FuNK3Y/picoKVM/hardware/revA/img/bottom.png

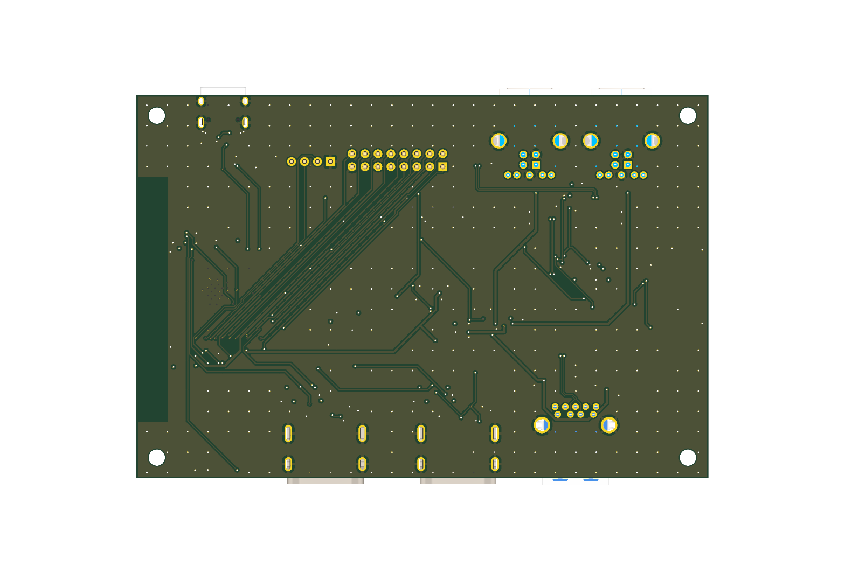
hardware/revA/img/bottom.png
