FuNK3Y/picoKVM/hardware/revA/img/top.png

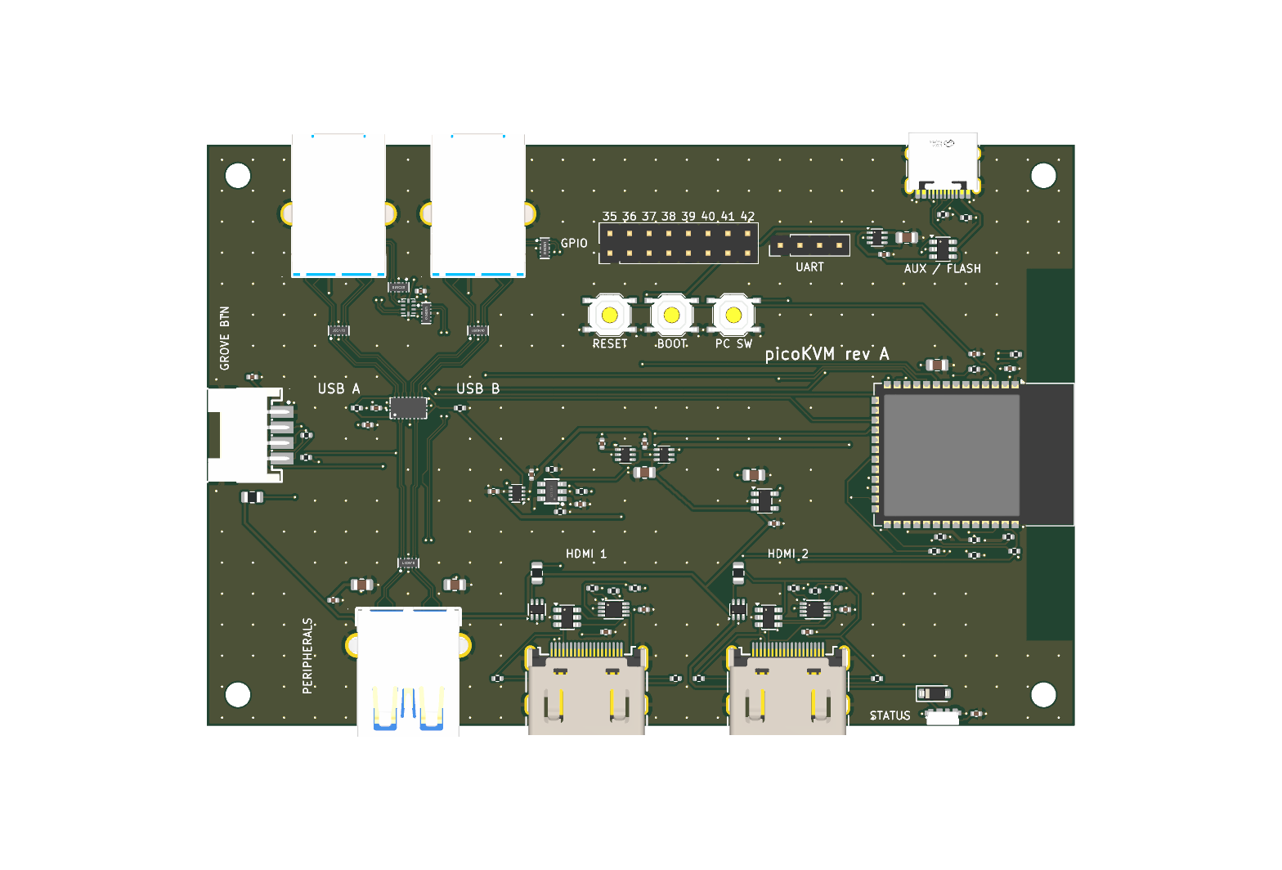
hardware/revA/img/top.png
