FuNK3Y/picoKVM/hardware/revA/kvm_board.kicad_pcb

## KiCad design hardware/revA/kvm_board.kicad_pcb (2026-10-26)

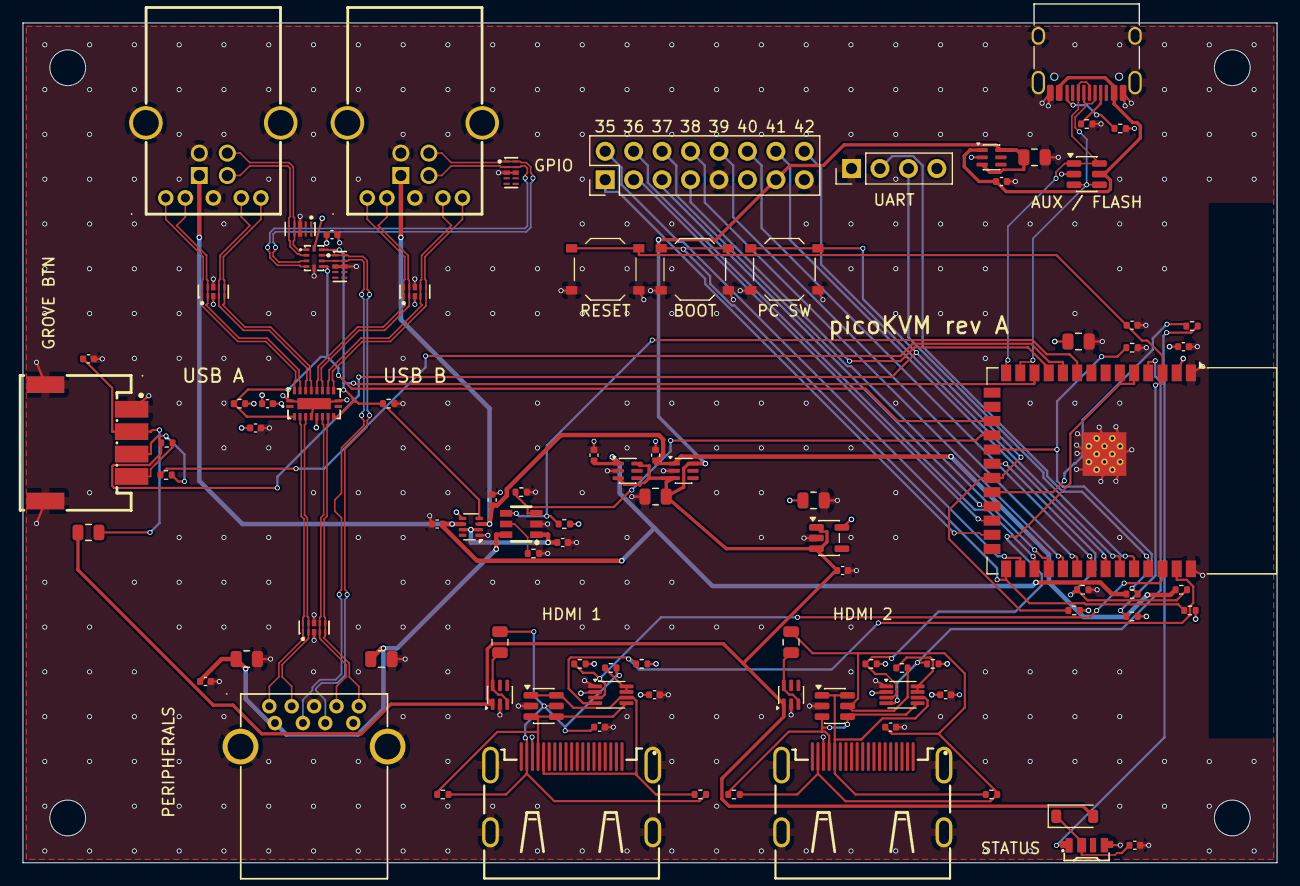
[picture p4: board kvm_board.kicad_pcb from above]

Board: 4 copper layers, 112.0 x 75.0 mm, 95 parts (0 on the bottom side), 75 nets.

Parts:
C1, C3, C6, C9, C14, C15, C16, C17, C19, C21, C22: 100nF; C_0402_1005Metric
C2, C4, C5, C10, C12, C20, C23, C24: 1uF; C_0402_1005Metric
C7, C8, C18: 22uF; C_0805_2012Metric
C11, C13, C25: 10uF; C_0805_2012Metric
D3: SK6812SIDE-A; LED-SMD_4P-L4.0-W1.6-L
D4: 1N4148W; D_SOD-123
F2, F3, F4: 100mA; Fuse_0805_2012Metric
H1, H2, H3, H4: MountingHole; MountingHole_3.2mm_M3
J1, J2: HC-USB3.0-L1845-BF; USB-B-TH_9P-L18.5-W12.0
J3: HC-USB3.0-L168-WP; USB-TH_USB3.0-A
J4: USB_C_Receptacle_USB2.0_16P; USB_C_Receptacle_HRO_TYPE-C-31-M-12
J5, J6: HDMI-001; HDMI-SMD_19P-P0.50-H-F
J7: UART; PinHeader_1x04_P2.54mm_Vertical
J8: GROVE_BTN; CONN-SMD_4P-P2.00_ZX-HY2.0-4PWT
J9: GPIO; PinHeader_2x08_P2.54mm_Vertical
R1, R2: 5.1k; R_0402_1005Metric
R3, R4, R6, R7, R8, R10, R22, R23, R24: 10k; R_0402_1005Metric
R5: 20k; R_0402_1005Metric
R9, R11: 15k; R_0402_1005Metric
R12, R17: 200k; R_0402_1005Metric
R13, R14, R18, R19: 4.7k; R_0402_1005Metric
R15, R16, R20, R21: 2k; R_0402_1005Metric
R25, R26, R27: 100; R_0402_1005Metric
SW1: RESET; SW_Push_1P1T_XKB_TS-1187A
SW2: BOOT; SW_Push_1P1T_XKB_TS-1187A
SW3: SWITCH; SW_Push_1P1T_XKB_TS-1187A
U1: ESP32-S3-WROOM-1-N8R2; ESP32-S3-WROOM-1
U2: HD3SS3212IRKSR; DHVQFN-20_L4.5-W2.5-P0.50-BL-EP
U3: TS3USB221ARSER; UQFN-10_L2.0-W1.5-P0.50-BL
U4: TPS2116DRL; SOT-583-8
U5: AP2112K-3.3; SOT-23-5
U6, U7, U8, U21, U22: LM66100DCK; SOT-363_SC-70-6
U9, U10: PCA9306DC; VSSOP-8_2.3x2mm_P0.5mm
U11, U12, U13, U17, U18, U19: TPD4E05U06DQAR_C138714; USON-10_L2.5-W1.0-P0.50-BL
U14, U15, U16: USBLC6-2SC6; SOT-23-6
U20: TPS2553DBVR; SOT-23-6_L2.9-W1.6-P0.95-LS2.8-BR

Connections:
+3V3: C1.1, C2.1, C3.1, C13.1, C15.1, C17.1, C18.1, C19.1, J7.4, J9.11, R4.2, R7.2, R13.2, R14.2, R18.2, R19.2, R22.2, R23.2, R24.2, U1.2, U2.6, U3.10, U4.5, U5.5, U9.2, U10.2
+5V_SYS: C11.1, C12.1, C25.1, D4.2, F4.1, J9.13, U5.1, U5.3, U6.3, U6.6, U7.3, U7.6, U8.3, U8.6, U21.1, U22.1
AUX_CC1: J4.A5, R1.1
AUX_CC2: J4.B5, R2.1
AUX_DN: J4.A7, J4.B7, U1.13, U14.3, U14.4
AUX_DP: J4.A6, J4.B6, U1.14, U14.1, U14.6
BOOT: R23.1, SW2.1, U1.27
BTN_SWITCH: R24.1, R26.1, SW3.1, U1.21
DDC1_SCL: R13.1, U1.38, U9.3
DDC1_SDA: R14.1, U1.39, U9.4
DDC1_VREF2: R12.1, U9.7, U9.8
DDC2_SCL: R18.1, U1.5, U10.3
DDC2_SDA: R19.1, U1.4, U10.4
DDC2_VREF2: R17.1, U10.7, U10.8
EN: C20.1, R22.1, SW1.1, U1.3
EXT_LED: R27.1, U1.10
GND: C1.2, C2.2, C3.2, C4.2, C5.2, C6.2, C7.2, C8.2, C9.2, C10.2, C11.2, C12.2, C13.2, C14.2, C15.2, C16.2, C17.2, C18.2, C19.2, C20.2, C21.2, C22.2, C23.2, C24.2, C25.2, D3.4, J1.4, J1.7, J1.10, J1.11, J2.4, J2.7, J2.10, J2.11, J3.4, J3.7, J3.10, J4.A1, J4.A12, J4.B1, J4.B12, J4.SH, J5.17, J5.20, J5.21, J5.22, J5.23, J6.17, J6.20, J6.21, J6.22, J6.23, J7.1, J8.1, J8.5, J8.6, J9.9, J9.15, R1.2, R2.2, R3.2, R5.2, R6.2, R9.2, R11.2, SW1.2, SW2.2, SW3.2, U1.1, U1.40, U1.41, U2.5, U2.11, U2.20, U2.21, U3.5, U4.1, U5.2, U6.2, U7.2, U8.2, U9.1, U10.1, U11.3, U11.8, U12.3, U12.8, U13.3, U13.8, U14.2, U15.2, U16.2, U17.3, U17.8, U18.3, U18.8, U19.3, U19.8, U20.2, U21.2, U22.2
GPIO18: J9.7, U1.11
GPIO21: J9.5, U1.23
GPIO35: J9.2, U1.28
GPIO36: J9.4, U1.29
GPIO37: J9.6, U1.30
GPIO38: J9.8, U1.31
GPIO39: J9.10, U1.32
GPIO40: J9.12, U1.33
GPIO41: J9.14, U1.34
GPIO42: J9.16, U1.35
GPIO47: J9.3, U1.24
GPIO48: J9.1, U1.25
GROVE_5V: C22.1, F4.2, J8.2
GROVE_BTN: J8.4, R26.2
GROVE_LED: J8.3, R27.2
HDMI1_5V: C14.1, F2.2, J5.18, R12.2, R15.2, R16.2, U15.5
HDMI1_5V_D: F2.1, U21.3, U21.6
HDMI1_SCL: J5.15, R15.1, U9.6, U15.1, U15.6
HDMI1_SDA: J5.16, R16.1, U9.5, U15.3, U15.4
HDMI2_5V: C16.1, F3.2, J6.18, R17.2, R20.2, R21.2, U16.5
HDMI2_5V_D: F3.1, U22.3, U22.6
HDMI2_SCL: J6.15, R20.1, U10.6, U16.1, U16.6
HDMI2_SDA: J6.16, R21.1, U10.5, U16.3, U16.4
LED_DIN: D3.1, R25.2
LED_RGB: R25.1, U1.22
LED_VDD: C21.1, D3.2, D4.1
PCA_DN: J1.2, U3.2, U11.5, U11.6
PCA_DP: J1.3, U3.1, U11.4, U11.7
PCA_SSRX_N: J1.8, U2.18, U17.2, U17.9
PCA_SSRX_P: J1.9, U2.19, U17.1, U17.10
PCA_SSTX_N: J1.5, U2.16, U17.5, U17.6
PCA_SSTX_P: J1.6, U2.17, U17.4, U17.7
PCB_DN: J2.2, U3.4, U12.2, U12.9
PCB_DP: J2.3, U3.3, U12.1, U12.10
PCB_SSRX_N: J2.8, U2.14, U18.2, U18.9
PCB_SSRX_P: J2.9, U2.15, U18.1, U18.10
PCB_SSTX_N: J2.5, U2.12, U18.5, U18.6
PCB_SSTX_P: J2.6, U2.13, U18.4, U18.7
PERIPH_EN: R6.1, U1.18, U20.3
PERIPH_FAULT_N: R7.1, U1.9, U20.4
PERIPH_ILIM: R5.1, U20.5
PER_DN: J3.2, U3.7, U13.2, U13.9
PER_DP: J3.3, U3.8, U13.1, U13.10
PER_SSRX_N: J3.5, U2.8, U19.5, U19.6
PER_SSRX_P: J3.6, U2.7, U19.4, U19.7
PER_SSTX_N: J3.8, U2.4, U19.2, U19.9
PER_SSTX_P: J3.9, U2.3, U19.1, U19.10
RXD0: J7.3, U1.36
TXD0: J7.2, U1.37
USB_OE_N: R4.1, U1.17, U2.2, U3.6
USB_SEL: R3.1, U1.12, U2.9, U3.9, U4.4
VBUS_A: C4.1, C23.1, J1.1, R8.1, U4.6, U6.1
VBUS_AUX: C10.1, J4.A4, J4.A9, J4.B4, J4.B9, U8.1, U14.5
VBUS_A_SENSE: R8.2, R9.1, U1.19
VBUS_B: C5.1, C24.1, J2.1, R10.1, U4.3, U7.1
VBUS_B_SENSE: R10.2, R11.1, U1.20
VBUS_PERIPH: C7.1, C8.1, C9.1, J3.1, U20.6
VBUS_PERIPH_RAW: C6.1, U4.2, U4.7, U20.1
