FuNK3Y/picoKVM/tests/test_webserver.py

import asyncio
import base64
import json
import unittest
from unittest.mock import patch

import mocks
from mocks import ClientSession, Partition, TestCase, image
from config import Config
from controller import Controller
from metrics_provider import MetricsProvider
from updater import Updater
from webserver import WebServer


class Device:
    def __init__(self):
        self.inputs = []

    async def set_active_input(self, input):
        self.inputs.append(input)

    def to_dict(self):
        return {}


class Writer:
    def __init__(self):
        self.data = b""

    def write(self, data):
        self.data += data.encode() if isinstance(data, str) else data

    async def drain(self):
        pass

    async def wait_closed(self):
        pass


def credentials(password):
    return "Authorization: Basic " + base64.b64encode(b"admin:" + password.encode()).decode() + "\r\n"


class WebServerTest(TestCase):
    def setUp(self):
        super().setUp()
        Config.wireless_network = {"hostname": "kvm"}
        Config.admin_password = "secret"
        Config.update_repository = "owner/repo"
        Config.devices = [Device()]
        self.updater = Updater()
        self.restarts = 0

        async def restart():
            self.restarts += 1

        self.updater.restart = restart
        self.server = WebServer(Controller(), MetricsProvider(self.updater), self.updater)

    async def request(self, head, body=b""):
        """Returns the status line, the headers and the body of the response (JSON decoded when it is)."""
        reader = asyncio.StreamReader()
        reader.feed_data(head.encode() + b"\r\n" + body)
        reader.feed_eof()
        writer = Writer()
        await self.server.handle_client(reader, writer)
        if writer.data.startswith(b"HTTP/1.1 100 Continue\r\n\r\n"):
            writer.data = writer.data[25:]
        headers, _, content = writer.data.partition(b"\r\n\r\n")
        status, *headers = headers.decode().split("\r\n")
        if "Content-Type: application/json" in headers:
            content = json.loads(content)
        return status, headers, content

    def upload(self, data, auth="secret", extra=""):
        head = f"POST /api/update HTTP/1.1\r\nContent-Length: {len(data)}\r\n{extra}"
        return self.request(head + (credentials(auth) if auth else ""), data)

    async def test_page(self):
        status, _, content = await self.request("GET / HTTP/1.1\r\n")
        self.assertEqual(status, "HTTP/1.1 200 OK")
        self.assertIn(b"<title>kvm</title>", content)

    async def test_config_page(self):
        self.assertEqual((await self.request("GET /config HTTP/1.1\r\n"))[0], "HTTP/1.1 401 Unauthorized")
        status, headers, content = await self.request("GET /config HTTP/1.1\r\n" + credentials("secret"))
        self.assertEqual(status, "HTTP/1.1 200 OK")
        self.assertIn("Content-Type: text/html", headers)
        self.assertIn(b"/api/config", content)

    async def test_stylesheet(self):
        status, headers, content = await self.request("GET /style.css HTTP/1.1\r\n")
        self.assertEqual(status, "HTTP/1.1 200 OK")
        self.assertIn("Content-Type: text/css", headers)
        self.assertIn(b"prefers-color-scheme: dark", content)

    async def test_active_input(self):
        status, _, content = await self.request("POST /api/active_input/B HTTP/1.1\r\n")
        self.assertEqual(status, "HTTP/1.1 200 OK")
        self.assertEqual(content, {"active_input": {"B": Config.inputs["B"]}, "switching": None, "error": None})
        self.assertEqual(Config.devices[0].inputs, ["B"])
        status, _, content = await self.request("GET /api/active_input HTTP/1.1\r\n")
        self.assertEqual(content, {"active_input": {"B": Config.inputs["B"]}, "switching": None, "error": None})

    async def test_unknown(self):
        self.assertEqual((await self.request("GET /nowhere HTTP/1.1\r\n"))[0], "HTTP/1.1 404 Not Found")
        self.assertEqual((await self.request("GET /api/nowhere HTTP/1.1\r\n"))[0], "HTTP/1.1 404 Not Found")
        self.assertEqual((await self.request("PUT /api/update HTTP/1.1\r\n"))[0], "HTTP/1.1 405 Method Not Allowed")
        self.assertEqual((await self.request("garbage\r\n"))[0], "HTTP/1.1 400 Bad Request")

    async def test_events(self):
        reader = asyncio.StreamReader()
        reader.feed_data(b"GET /api/events HTTP/1.1\r\n\r\n")
        writer = Writer()
        stream = asyncio.ensure_future(self.server.handle_client(reader, writer))
        await asyncio.sleep(0.05)
        await self.server.controller.set_active_input("B")
        await asyncio.sleep(0.05)
        head, _, body = writer.data.partition(b"\r\n\r\n")
        self.assertIn(b"Content-Type: text/event-stream", head)
        events = [json.loads(line[6:]) for line in body.split(b"\n\n") if line]
        self.assertEqual([(list(event["active_input"]), event["switching"] and list(event["switching"])) for event in events], [(["A"], None), (["A"], ["B"]), (["B"], None)])

        self.server._EVENT_INTERVAL = 0.05  # The state is sent again while nothing changes
        self.server.controller._notify()  # Ends the current, longer wait
        await asyncio.sleep(0.3)
        self.assertGreater(writer.data.count(b"data: "), 3)

        async def gone():
            raise OSError("ECONNRESET")

        writer.drain = gone  # The page closes: the stream ends quietly
        await asyncio.wait_for(stream, 1)
        self.assertEqual(self.server._event_streams, 0)

    async def test_events_limit(self):
        self.server._event_streams = self.server._MAX_EVENT_STREAMS
        self.assertEqual((await self.request("GET /api/events HTTP/1.1\r\n"))[0], "HTTP/1.1 503 Service Unavailable")

    async def test_paths(self):
        self.assertEqual((await self.request("POST /api/active_input/B/ HTTP/1.1\r\n"))[0], "HTTP/1.1 200 OK")
        self.assertEqual((await self.request("POST /api/active_input/ HTTP/1.1\r\n"))[2]["active_input"], {"A": Config.inputs["A"]})  # Toggles
        self.assertEqual((await self.request("POST /api/active_input/C HTTP/1.1\r\n"))[0], "HTTP/1.1 404 Not Found")
        self.assertEqual((await self.request("GET /api/active_input/A HTTP/1.1\r\n"))[0], "HTTP/1.1 405 Method Not Allowed")
        self.assertEqual((await self.request("GET /api/update/ HTTP/1.1\r\n"))[0], "HTTP/1.1 200 OK")

    async def test_errors(self):
        status, _, content = await self.request("POST /api/update HTTP/1.1\r\nAuthorization: Basic A\r\n")  # Not base64
        self.assertEqual(status, "HTTP/1.1 401 Unauthorized")
        Config.devices[0].set_active_input = None  # Not callable: the switch fails
        status, _, content = await self.request("POST /api/active_input/B HTTP/1.1\r\n")
        self.assertEqual(status, "HTTP/1.1 500 Internal Server Error")
        with patch.object(Updater, "install", side_effect=OSError("flash failure")):
            status, _, content = await self.upload(image("v2.0.0"))
        self.assertEqual((status, content), ("HTTP/1.1 500 Internal Server Error", {"message": "flash failure"}))
        status, _, _ = await self.request("GET / HTTP/1.1", b"\xff\r\n\r\n")  # Undecodable header: the connection is dropped
        self.assertEqual(status, "")

    async def test_config(self):
        self.assertEqual((await self.request("GET /api/config HTTP/1.1\r\n"))[0], "HTTP/1.1 401 Unauthorized")
        status, _, content = await self.request("GET /api/config HTTP/1.1\r\n" + credentials("secret"))
        self.assertEqual(status, "HTTP/1.1 200 OK")
        self.assertEqual(content, Config.public())

        def post(body):
            return self.request(f"POST /api/config HTTP/1.1\r\nContent-Length: {len(body)}\r\n" + credentials("secret"), body)

        from test_config import settings

        Config.wireless_network = {"SSID": "home", "hostname": "picokvm", "password": "wifi"}  # As settings() has it
        status, _, content = await post(json.dumps(settings()).encode())
        self.assertEqual((status, content), ("HTTP/1.1 200 OK", {"message": "Saved", "restart": False}))
        self.assertEqual(self.restarts, 0)
        status, _, content = await post(json.dumps(settings(wireless_network={"SSID": "other", "hostname": "kvm"})).encode())
        self.assertEqual(content, {"message": "Saved, restarting", "restart": True})
        await asyncio.sleep(0)
        self.assertEqual(self.restarts, 1)
        self.assertEqual((await post(b"{not json"))[0], "HTTP/1.1 400 Bad Request")
        status, _, content = await post(json.dumps(settings(led_idle_brightness=5)).encode())
        self.assertEqual((status, content["message"]), ("HTTP/1.1 400 Bad Request", "LED brightness: from 0 to 1"))
        self.assertEqual((await post(b" " * 20000))[0], "HTTP/1.1 413 Content Too Large")
        status, _, _ = await self.request("POST /api/config HTTP/1.1\r\n" + credentials("secret"))
        self.assertEqual(status, "HTTP/1.1 411 Length Required")

    async def test_metrics(self):
        status, _, content = await self.request("GET /metrics HTTP/1.1\r\n")
        self.assertEqual(status, "HTTP/1.1 200 OK")
        self.assertIn(b'picokvm_info{version="v1.0.0"} 1', content)
        self.assertIn(b'usb_input_powered{input="A"}', content)

    async def test_open_without_admin_password(self):
        Config.admin_password = None
        status, _, content = await self.request("GET /api/config HTTP/1.1\r\n")
        self.assertEqual(status, "HTTP/1.1 200 OK")
        self.assertEqual(content["update_repository"], "owner/repo")

    async def test_update_needs_the_password(self):
        data = image("v2.0.0")
        for auth in ("wrong", None):
            status, headers, _ = await self.upload(data, auth)
            self.assertEqual(status, "HTTP/1.1 401 Unauthorized")
            self.assertIn('WWW-Authenticate: Basic realm="picoKVM"', headers)
        self.assertIsNone(Partition.booted)

    async def test_upload(self):
        status, _, content = await self.upload(image("v2.0.0"), extra="Expect: 100-continue\r\n")
        self.assertEqual(status, "HTTP/1.1 200 OK")
        self.assertEqual(content, {"message": "Restarting into v2.0.0", "version": "v2.0.0"})
        await asyncio.sleep(0)
        self.assertEqual(self.restarts, 1)
        self.assertEqual(Partition.booted, "ota_1")

    async def test_bad_uploads(self):
        status, _, content = await self.upload(image("v2.0.0", chip=0))
        self.assertEqual(status, "HTTP/1.1 400 Bad Request")
        self.assertIn("ESP32-S3", content["message"])
        status, _, _ = await self.request("POST /api/update HTTP/1.1\r\n" + credentials("secret"))
        self.assertEqual(status, "HTTP/1.1 411 Length Required")
        self.assertEqual(self.restarts, 0)

    async def test_version(self):
        status, _, content = await self.request("GET /api/update HTTP/1.1\r\n")
        self.assertEqual(content, {"version": "v1.0.0", "status": None})

    async def test_latest_release(self):
        from test_release import API, serve

        serve()
        _, _, content = await self.request("GET /api/update/latest HTTP/1.1\r\n")
        self.assertEqual(content, {"version": "v1.0.0", "latest": "v2.0.0", "update_available": True})
        self.assertEqual((await self.request("POST /api/update/latest HTTP/1.1\r\n"))[0], "HTTP/1.1 401 Unauthorized")
        status, _, content = await self.request("POST /api/update/latest HTTP/1.1\r\n" + credentials("secret"))
        self.assertEqual(status, "HTTP/1.1 200 OK")
        self.assertEqual(content["version"], "v2.0.0")
        ClientSession.served[API] = (500, b"{}")
        status, _, content = await self.request("GET /api/update/latest HTTP/1.1\r\n")
        self.assertEqual(status, "HTTP/1.1 502 Bad Gateway")
        self.assertIn("500", content["message"])


if __name__ == "__main__":
    unittest.main()
