FuNK3Y/picoKVM/(commit log)

2025-02-08 Fix power_on
2025-02-08 Sample config file
2025-02-08 Readme & fix command_delay
    [samsung_monitor.py]
2025-02-08 Fix token aquisition flow
    [samsung_monitor.py]
2025-02-09 Add blinking led, rename set_active_input
2025-02-24 Add physical button mgmt
2025-02-24 Fix racing condition that led to the LED remaining on
    [controller.py]
2025-02-25 Properly cancel the blinking if case of exception
2025-02-28 Fix initial irq trigger on boot
    [main.py]
2025-04-21 Switch from interupt to polling not to mess with asyncio
2025-04-22 Remove powerstate check as using KEY_POWER is not mandary for wake up Update readme & config accordingly
2025-06-01 - Disable wifi power mgmt. - Rename set_active_input and get_active_input to active_input to be more REST
2025-06-01 Revert "Reuse aiohttp over different call."
    This reverts commit b5aa8036a9db4efd8c93f0e05cf689e5125a7603.
    [generic_device.py, samsung_monitor.py]
2025-06-06 Use constant for powersave, harmonize private attribute naming
2025-06-14 Fix sample config nesting
2025-06-15 Add some explicit garbage collecting to fight error 12
    [controller.py]
2025-07-14 Add mcu temperature
2026-09-21 Fix config sample, hostname timing and HTTP request handling
    Bugs:
    - config.json had "hostname" nested inside "command_sequences", so
    SamsungMonitor.from_dict() raised TypeError and the device could not
    boot from a fresh clone. Introduced in f39db3f.
    - "Autorization" -> "Authorization" in the SmartThings sample headers.
    - The 500 path passed the exception object to json.dumps(), which is not
    serializable, so the error handler threw and the client got a dropped
    connection instead of a response.
    - SamsungMonitor captured network.hostname() in __init__, which runs
    during Config.load(), before connect() sets it. The monitor therefore
    paired against the board default name. It is now a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
    [button_handler.py, config.py, controller.py, generic_device.py, samsung_monitor.py, webserver.py]
2026-09-21 Reap abandoned device tasks when a switch times out
    asyncio.wait_for raises in the waiter but, unlike CPython, MicroPython's
    gather does not cancel the child tasks it was awaiting. A device task
    that is still mid-TLS-handshake therefore keeps running with its socket
    open: the `async with ws_connect(...)` __aexit__ never executes, so the
    mbedtls context, its record buffers and the parsed certificate chain
    (20KB or so on the ESP-IDF heap) are only released whenever the monitor
    eventually hangs up.
    Observed on hardware: a monitor dropped into standby during a switch,
    the 20s timeout fired, and the following presses failed with
    MBEDTLS_ERR_MPI_ALLOC_FAILED and MBEDTLS_ERR_X509_ALLOC_FAILED. Tho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
    [controller.py]
2026-09-21 Raise the switch timeout to 45s and retry once
    A monitor that has dropped into standby has to bring its websocket
    service back up before it will accept a connection, and KEY_RETURN (the
    key that wakes it) can only be sent over that connection. So the wake
    path is gated on the very thing standby delays. 20s was sized for the
    command sequence, which only needs about 3.6s, and was too tight for a
    cold service: a monitor going to sleep between switches was enough to
    time out.
    Now that a timed-out attempt is cleaned up rather than abandoned, a
    retry is cheap, so allow two attempts of 45s. The reaping runs in the
    inner finally, before the next attempt starts, so a retry never begins
    while the pre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
    [controller.py]
2026-09-21 Collect garbage before each switch attempt
    MicroPython's open_connection connects a raw TCP socket and only then
    calls ssl.wrap_socket. When wrap_socket fails with ENOMEM the connected
    socket is never closed explicitly: it is reachable only from a dead
    local, so its lwIP allocation survives until the garbage collector runs
    its finaliser. Every failed attempt therefore strands another socket on
    the ESP-IDF heap, which is how an ENOMEM storm becomes self-sustaining
    across both attempts and every subsequent button press.
    gc.threshold() cannot help here because it fires on MicroPython GC heap
    pressure, and the two pools are decoupled: during the incident gc_free
    sat around 103KB with no pressur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
    [controller.py]
2026-10-03 Add the picoKVM board (rev A) hardware design
    ESP32-S3 KVM board: USB 3.0 switching between two computers (HD3SS3212 +
    TS3USB221A, switched and current-limited peripheral power), two HDMI ports
    carrying DDC/CI for monitor input control, RGB status LED and a Grove port
    for an M5Stack key unit.
    hardware/ holds the generated-PCB sources (SKiDL netlist, placement,
    hand-routed USB pairs, Freerouting round-trip, JLC panel and fab outputs),
    the LCSC part libraries (only the 3D models the board uses), the pinned
    Docker toolchain (KiCad 10.0.6), and revA/ with the routed board of record
    and the exact files ordered from JLCPCB.
    [bom.csv, kvm_board.kicad_pcb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]
2026-10-03 Support the picoKVM board in the firmware
    - DdcMonitor device: switch monitor inputs over the board's HDMI DDC/CI
    ports (VESA MCCS VCP 0x60, optional power-on via VCP 0xD6)
    - Enable the board's USB data switches at boot and power the peripheral
    port; cycle peripheral power on each switch so the peripheral
    re-enumerates on the new computer
    - Several status LEDs (on-board + Grove key), optionally kept lit in the
    active input's color
    - /metrics: which computers power their USB port, peripheral fault flag
    - config.example.json targets the board; AtomS3 configs keep working
    (all board settings are optional)
2026-10-03 Default to the picoKVM board's pins; document DDC/CI requirements
    - config.py defaults are now the board's GPIOs; AtomS3 setups set their
    own pins and null for the board-only signals (README shows the block)
    - README: the monitor must accept DDC/CI on an inactive input, and the
    monitor brands tested so far (AOC, Samsung, Dell, Acer, Lenovo)
2026-10-03 README: show the HDMI DDC/CI link in the wiring diagram
2026-10-03 hardware: add manufacturing checks beyond DRC
    hw/checks.py (make checks, part of every build) checks what JLCDFM flags
    and KiCad's DRC does not: vias within 0.11 mm of any pad, SMD pads within
    2.03 mm of another part's through-hole pad, tracks within 0.08 mm of a
    mask opening they do not enter, and USB 2 D+/D- skew along the copper
    path. The released rev A board passes.
2026-10-03 ESPHome external component for the picoKVM board
    picokvm select platform: USB switch (with the peripheral power cycle) and
    DDC/CI input switching over the board's two HDMI DDC buses, pins defaulting
    to the board's. esphome/picokvm.yaml wires button, LEDs and VBUS/fault
    sensors with stock components. Builds with ESPHome 2026.9.1.
2026-10-03 ESPHome: stock components instead of a custom component
    The board needs no C++ component: gpio outputs, a template select,
    i2c_device per HDMI port and a short lambda for the DDC/CI frame do the
    same, in one YAML file.
    [picokvm.yaml]
2026-10-03 ESPHome: board logic as a package, example user config
    picokvm.yaml becomes an includable package; monitor input values and
    input names are nested substitutions that a user config overrides one by
    one. example.yaml includes it from GitHub and shows an !extend hook.
2026-10-03 ESPHome: monitor settings as runtime configuration entities
    Per HDMI port: an on/off switch for whether a monitor follows the input,
    and the VCP 0x60 value per computer as numbers, restored after reboot and
    editable from Home Assistant without a rebuild. Monitors on separate buses
    are switched together. Computer names stay build-time: select options are
    fixed and cached by Home Assistant.
    [picokvm.yaml]
2026-10-03 ESPHome: number of monitors (1 or 2) at build time
    monitors: 2 merges an inline package with the HDMI 2 input numbers and
    its switching step; with 1 they do not exist, so the device page only
    shows what is used. Both DDC buses and devices stay in the core (the
    board always has them, scan off). Replaces the per-port on/off switches.
    [picokvm.yaml]
2026-10-06 README: flash the plain ESP32_GENERIC_S3 build
    There is no separate SPIRAM build any more: the generic one detects the
    N8R2's quad PSRAM at boot, and SPIRAM_OCT (the only other PSRAM option)
    is for octal PSRAM, so naming a "SPIRAM variant" pointed at the wrong
    image.
2026-10-26 README: show a dedicated USB hub in the wiring schema
    The keyboard, mouse and KVM were wired to the monitor node, which made
    the monitor implicitly act as the USB hub. Add an explicit USB hub node
    and note that the monitor's built-in hub can fill that role.
    Claude-Session: https://claude.ai/code/session_01JEY3D9bLPWQCzVaJKbJK1p
2026-10-26 Build the firmware: MicroPython with the code frozen in, two app slots
    The application moves to src/ and is frozen into a MicroPython build for
    the ESP32-S3 (firmware/PICOKVM): the generic S3 configuration, 8 MiB of
    flash, and MicroPython's 8MiBplus-ota partition table, two 2.4 MiB
    application slots ahead of the filesystem, so that the firmware can
    later update itself, MicroPython included, with the bootloader's
    rollback. aiohttp is frozen in too, and index.html becomes a generated
    module, as frozen code cannot open files.
    firmware/build.sh builds it with ESP-IDF v5.5.2 and MicroPython v1.29.0;
    GitHub Actions runs it on every push and publishes the images as a
    release on v* tags. The versio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
2026-10-26 Confirm an update only once the firmware comes up healthy
    updater.py holds the update logic. An update will be written to the
    application slot not running, with a state file naming that slot; the
    bootloader then starts it in a pending state, and rolls back to the
    previous firmware at the next reset unless the application confirms it.
    On that trial boot, main.py starts a watchdog before anything else, and
    confirms the update once the configuration is loaded, the web server
    listens and Wi-Fi is up. Not healthy within 2 minutes, it restarts into
    the previous firmware; a crash or a hang does the same through the
    watchdog. Normal boots run without a watchdog, so the REPL stays usable.
    After a ro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
2026-10-26 Add password-protected firmware uploads: POST /api/update
    The body is an application image (firmware-ota.bin). It is streamed in
    4 KiB blocks into the application slot not running, then set to boot
    after the bootloader's own checks (checksum, and the SHA-256 the image
    carries), and the device restarts into it for the trial boot. Images
    that are not picoKVM firmware for the ESP32-S3 are refused from their
    first block, before anything is written. The switch lock is held while
    writing, and each read times out, so a stalled upload cannot block the
    KVM.
    config.json gains admin_password, checked as HTTP Basic credentials
    (any user name). Unset, the API calls that change the device are
    refused: fi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
2026-10-26 Update from the latest GitHub release, from the web page or the API
    GET /api/update/latest looks up the latest release of update_repository
    (config.json, FuNK3Y/picoKVM by default), and POST /api/update/latest,
    password-protected, downloads its firmware-ota.bin straight into the
    free application slot, checked against the SHA-256 GitHub gives for
    it, then restarts into it as for an upload. The download is bounded in
    time, as the switch lock is held throughout.
    The web page shows the running firmware version (and the outcome of the
    last update), with a "Check for updates" link that becomes "Update to
    <version>"; the browser asks for the admin password, then the page
    waits for the device to co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
2026-10-26 firmware: check that the updater accepts the built image
    The build ends by reading firmware-ota.bin's first block with the
    updater's own parser, so that a change to the image layout or to the
    version marker fails the build instead of every update on the board.
    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
2026-10-26 Refuse an update while the running one is on trial
    Until the running update is confirmed, the other application slot holds
    the previous firmware, the one the bootloader rolls back to: writing a
    new update there would leave nothing known-good to go back to.
    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
2026-10-26 Support the picoKVM board only
    The firmware's flash layout and update scheme already target the
    board; drop what remained for the original AtomS3 Lite + USB multiplexer
    build: the board-only pins are no longer optional (null), the LED pin
    is always a list, and the README describes the board alone, pointing
    to 5d5997c as the last version for the Atom.
    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
2026-10-26 Add tests: the application on CPython, with the board mocked
    tests/mocks.py stands in for the MicroPython modules (machine, esp32
    partitions, network, neopixel, aiohttp...), so that unittest covers the
    updater (image checks, install, trial, rollback), the GitHub release
    updates, the web server (routes, password, uploads) and the controller
    (peripheral power cycling, retries). GitHub Actions runs them on every
    push.
    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
2026-10-26 Fix the board's pins in the firmware: src/board.py
    With a single board supported, its pins are constants rather than
    settings: board.py holds them, and config.json keeps what is the
    user's (Wi-Fi, inputs, LED brightness, password, monitors). A DDC/CI
    monitor names its HDMI port ("hdmi": 1 or 2) instead of two pins.
    Config now loads and saves an explicit list of settings, so the pin
    settings of an earlier config.json are ignored, then dropped on save.
    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
2026-10-26 Web server: route table, response helpers, protected routes
    Requests are dispatched from a table of (method, path) to handlers,
    instead of a chain of regular expressions per method; trailing slashes
    are ignored as before, and a known path with another method answers
    405. The routes that change the device are listed once as protected,
    which checks admin_password before their handler runs: the editable
    configuration will only have to add its routes there. json_response()
    and error() replace the json.dumps() repeated in every answer.
    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
2026-10-26 Small cleanups
    - Config's save, load and _serialize are static methods, as called;
    - the controller's power-cycled USB switch is one async method, instead
    of a flag telling the caller to wait and restore power;
    - samsung_monitor imports binascii, not its deprecated ubinascii alias;
    - ButtonHandler's counter follows the code's naming (_down_count).
    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
2026-10-26 Tests: cover the whole application, measured in CI
    New tests for the button (press, contained errors, long-press reset),
    the monitors (Samsung pairing and key sequences, generic HTTP requests,
    DDC/CI power-on and missing monitor), main.py (start-up, and the
    confirmation of an update once on Wi-Fi), the configuration on FAT, and
    the web server's error paths. The mocks gain aiohttp requests and
    websockets, and the Wi-Fi calls main.py makes.
    src/ is now fully covered (99% with branches); CI reports it and fails
    under 95%.
    samsung_monitor encodes the hostname before base64: the same on
    MicroPython, which takes a str there, and what CPython requires.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
2026-10-26 Keep the web page as a module in src/: index_html.py
    Frozen code cannot open files, so generate.py turned index.html into a
    module at build time. Write the page as that module directly instead:
    it is frozen with the rest of src/, what the repository holds is what
    the board serves, and the tests no longer need a generation step.
    generate.py now only writes the version.
    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
2026-10-26 Web page: follow the KVM's state as it changes
    The page only learned the active input when it loaded or switched
    itself: a switch from the button or another page left it stale.
    The controller now publishes its state (active input, the input being
    switched to, the last switch error) and an event replaced on every
    change. GET /api/events streams it as server-sent events: on every
    change, and every 20 s otherwise, which also finds closed pages. Four
    streams at most, as each holds a socket. The page listens with an
    EventSource, shows "Switching to ..." pulsing during a switch, and the
    error below the button. GET /api/active_input answers the same state.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
2026-10-26 Configuration API: GET and POST /api/config, password-protected
    Config.public() gives the settings without the Wi-Fi and admin
    passwords; Config.apply() checks a whole set of settings (Wi-Fi, input
    names and colours, LED brightness, update repository, monitors, built
    to validate them) before changing anything, then applies and saves it.
    A password is only sent to change it, so the page cannot blank the
    admin password. Only Wi-Fi changes restart the device: a restart drops
    the USB peripherals for a moment. Devices are looked up in a table of
    the known types rather than in the module's globals.
    The web server ignores clients that went away instead of logging them,
    as every closed page now doe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
2026-10-26 Configuration page at /config, with the firmware updates
    A password-protected page (the browser asks for the admin password)
    over GET/POST /api/config: Wi-Fi (restarts the device), input names and
    colours, idle LED brightness, the admin password, and the monitors: a
    form for each DDC/CI monitor (HDMI port, input values, power on), a JSON
    box for the other devices, checked by the device on saving.
    Firmware updates move there from the main page: the running version and
    the last update's outcome, checking for and installing the latest
    release, uploading a firmware-ota.bin with a progress bar, and the
    update repository. The main page keeps the version, and links to the
    settings.
    Co-Authored-By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
2026-10-26 Survive a soft reboot: keep or restart the Wi-Fi connection
    A soft reboot (Ctrl-D, or Thonny connecting) restarts MicroPython but
    not the ESP32's Wi-Fi driver. Connecting again while its previous
    attempt was still in progress raised "Wifi Internal State Error", which
    ended main() before the web server started (and, on an update's trial
    boot, would have rolled the update back). connect() now keeps a
    connection that is still up, and ends an attempt in progress before
    starting its own.
    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
2026-10-26 Web pages: version only in the settings, full-width LED slider
    The main page drops the firmware version: the settings page shows it,
    with the updates. The settings page's form style no longer applies to
    the LED brightness slider: its padding and border kept the slider's
    track from reaching either end at 0% and 100%.
    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
2026-10-27 Wi-Fi from the browser: Improv Serial and a GitHub Pages installer
    - src/improv.py: Improv Wi-Fi over the USB serial port (state, device info,
    network scan, hostname, credentials), saved to config.json once connected
    - A new device (no config.json) starts on defaults and waits for Improv
    - admin_password is optional: while unset, the settings and the API calls
    that change the device are open
    - install/index.html: ESP Web Tools installer, published to GitHub Pages
    with each release's firmware.bin and manifest.json
2026-10-27 REPL on the USB Serial/JTAG port: flash and set Wi-Fi without the BOOT button
    MicroPython's TinyUSB port is another USB device than the ROM bootloader's
    USB Serial/JTAG one: after an install the browser lost the board, and
    esptool could not restart it into the bootloader. With the REPL on USB
    Serial/JTAG, both keep the same port.
2026-10-27 README: one section per step (install, wiring, settings, use)
    Wiring and monitor settings were split between 'Monitors' and 'How to use'.
2026-10-28 Settings: Detect and Switch to buttons for DDC/CI monitors
    Detect reads the monitor's name from its EDID (it answers even with DDC/CI
    off) and its current input (VCP 0x60), and offers that value for either
    computer. Switch to sends the form's value, saved or not. Both go through
    POST /api/ddc, behind the admin password and the controller's lock.
2026-10-28 Settings: read DDC/CI monitors instead of testing them
    The Detect and Switch to buttons go. The page reads each monitor when it
    opens and when the port changes (Refresh to read again), and shows its name
    and current input. The input values become lists: the inputs the monitor
    gives in its capabilities string, or the common ones, plus the values
    already set and Other value... Names come from the MCCS table, in the page.
    The current input is trusted once two reads agree; capabilities fragments
    are checked and retried, and garbage values are skipped. POST /api/ddc
    becomes a read-only GET /api/ddc?hdmi=<port>.
2026-10-28 Fix the query string and repository check on MicroPython; monitors as cards
    MicroPython refuses slices with a step, and has no str.isalnum(): requests with
    a query string got no answer, and saving the settings failed. Found on the
    device; checked on MicroPython's Unix port.
    Each monitor is now a card, so the Add buttons read as outside of it.
2026-11-03 Settings: Clear password button removes the admin password
    An empty admin_password means unchanged, so nothing could remove one once
    set. A null now does. On the page, Clear password shows "Cleared" in the
    field and the next save removes it. GET /api/config tells whether a password
    is set (admin_password_set), so the button only shows when there is one.
2026-11-06 ESPHome: LED colors and brightness at runtime, entities reorganized
    The input LED colors were hardcoded. Each input now has a "LED color for
    <computer>" text entity (#RRGGBB), and one "LED brightness" number drives
    both LEDs, which are no longer entities of their own.
    Key is now Button; the USB power sensors take the input names; those and
    the port fault sensor move to Diagnostic. Inputs are matched by index, so
    a name no longer ends up in the C++.
